JuperTronic/Jupertronic_Perculator_Mini_Pops/Perculator_Display_diagram.jpg

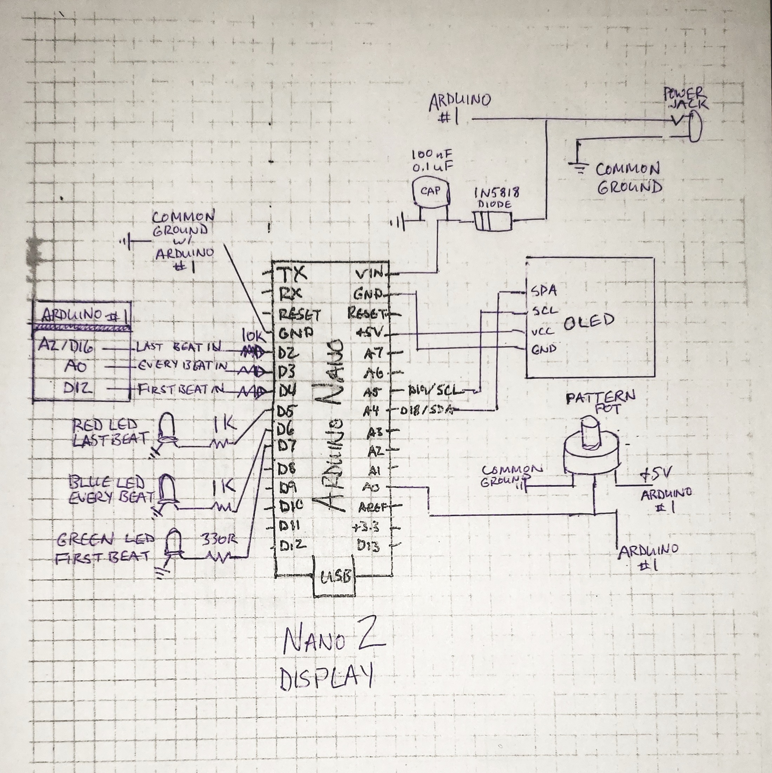
Perculator_Display_diagram.jpg
