JuperTronic/Jupertronic_Perculator_Mini_Pops/(threads)

Thread 1 (2022-04-20):

Pattern pot incorrectly wired

craigyjp, 2022-04-20:
I was interested in adding this display to my existing mini pops Wee 03 build, but looking at the pattern pot you seem to have the center pin wired to +5v so when rotated you would effectively short +5v to ground. I know the pin numbering is correct but the pdf file connections are not. Maybe I'm wrong, but the pattern value will never change as it stands currently.

JuperTronic, 2022-04-20:
Ahh yes, thank you for letting me know. As stated, I'm not a Fritzing wiz! I'll update that. Go by the hand drawing - center lug for signal of course.

JuperTronic, 2022-04-20:
Okay, just updated the Fritz schem pdf. Thanks again for bringing that to my attention!

craigyjp, 2022-04-20:
Thanks, just wanted to make sure before I added it to my build.

Thread 2 (2022-10-30):

Question regarding changes to the original TheWeeO3 code...

mayasfinest, 2022-10-30:
Hi, tremendous work you did and thank you for sharing it :-)

I built the "original" TheWeeO3 some months ago and love the things you could do when remote controlling it with a Korg SQ-1.
Have you touched any of the functionality regarding the CV and Korg LittleBits input in your code?
Do you think I could just build your machine with all of Mark Dammers CV-inputs?
[TheWeeO3-schematics.pdf](https://github.com/JuperTronic/Jupertronic_Perculator_Mini_Pops/files/9896188/TheWeeO3-schematics.pdf)

Greetings,
Jörg

JuperTronic, 2022-10-30:
Hi Jörg,

My psychic senses must have been tingling because I was just thinking about this a few days ago. I think there might be a slight change you'd want to make in my code. I'm not able to open the code right now, but I wanted to go ahead and respond. I'll try to look at the details soon. Here's what I remember. At the time I built the Perculator I didn't build in the CV jacks because I didn't have any equipment to drive it that way. I changed the way the LEDs work vs Mark Dammers' code, and I think I may have repurposed 1 or more pins of his CV output just for LED control. If you compare the code in that portion, you could probably just reset it to Mark's and the rest will work fine.

Actually now that I think about it, you should be able to add the second Arduino with OLED without touching the code or cicuit layout on your original WeeO3 Arduino at all. If you want to use my updated beat programs, just swap those in. The  second Arduino running the OLED just needs to get the input directly from the pattern potentiometer (which will also run to your WeeO3 Arduino - just attach 2 wires to the center pin of the potentiometer & and connect one to each Arduino - this is totally safe). Also create a common ground from each Arduino. The Arduinos themselves don't communicate to each other. So adding the OLED controlling Arduino does not require code changes to the beat making Arduino.

After all that rambling, I hope that makes sense. The WeeO3 original should work just fine.

I hope that helps! I'd love to hear how your project goes. Please let me know. I was thinking of going back to the WeeO3 CV design now that I have a Beatstep Pro as I think I can use it to send CV controls to expand the pattern possibilities on the Perculator.

Wishing you well,
Janis

-------- Original message --------
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

mayasfinest, 2022-10-30:
Hi Janis, thanks for the extensive answer, I very much appreciate it.
These CV-In's are really fun and open up the machine for a new experience, you should definately try it out.
The patterns are due to their preset nature quite limited and just turning on/off instruments is always "dejà-vueish".
You can do crazy things with CV-pitch and CV-sequencing up to the level of unrecognizable.
I'll try what you suggested, but the enclosure of my "Son of 8 Bit" (as I called my machine ;-) is overcrowded with pots and LEDs so I maybe build a new one... as I also miss a resonant filter and a volume knob before the output.

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

I am a rookie programmer and this code is far beyond my skills, so I'd love to see you doing the implementation of the CVs, if you don't mind :-) Maybe it's just a piece of cake for you...? I'll have to order these nice displays anyway (great idea btw)

In Germany it's evening, so have a nice one
and let me know, if you plan to actually change the code for "us" ...
Jörg
