JuperTronic/Jupertronic_Perculator_Mini_Pops/Perculator_Display_schem.pdf

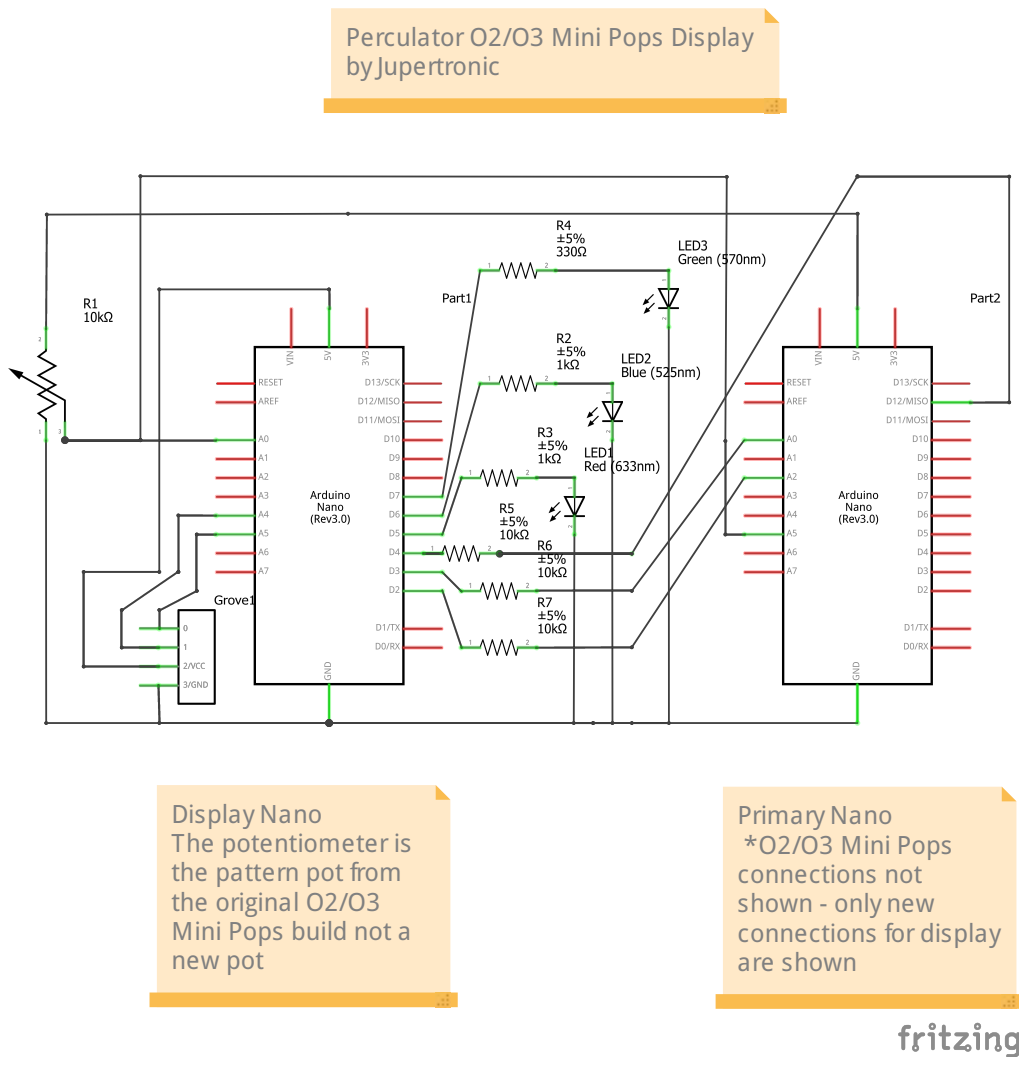
[picture p4: page 1]

Perculator O2/O3 Mini Pops Display
by Jupertronic

Display Nano
The potentiometeris
the pattern pot from
the original O2/O3
Mini Pops build not a
new pot

Primary Nano
*O2/O3 Mini Pops
connections not
shown - only new
connections for display
are shown
