JuperTronic/Jupertronic_Perculator_Mini_Pops/Jupertronic_Perculator_O3Minipops/Jupertronic_Perculator_O3Minipops.ino

// Perculator Mini Pops Drum Machine 2022
// Janis Wilson Hughes aka Jupertronic aka vitalWho aka J Dub aka Evolution Stoneware (youtube)
// Original code: O2 Minipops rhythm box (c) DSP Synthesizers 2016
// Free for non commercial use - http://janostman.wordpress.com - (website no longer working)
// See revival of this project by Bloghoskins.
// This iteration based on The Wee O3 by Mark Dammer 2020 - 'An ionized O2 Minipops' with awesome enhanced functionality. https://github.com/mark-orion/The-Wee-O3
// Thank you Jan, Bloghoskins, & Mark! 
// Changed LED flash to last beat of pattern
// Set up for 4 On the Floor beats and Rock Beats coded in Perculator_data.h
// Revised to use with a second Arduino board to run an OLED display showing the pattern name and number as well as operating LEDs.
// The pattern pot is wired with a second output going to the display Arduino's A0.
// A0, A2/D16, and D12 from this board go to display Arduino D3, D2, and D4 respectively with 10K resistors in series.


#include <avr/interrupt.h>
#include <avr/io.h>
#include <avr/pgmspace.h>
#include "Perculator_data.h"

#ifndef cbi
#define cbi(sfr, bit) (_SFR_BYTE(sfr) &= ~_BV(bit))
#endif
#ifndef sbi
#define sbi(sfr, bit) (_SFR_BYTE(sfr) |= _BV(bit))
#endif

// Standard Arduino Pins

#define digitalPinToPortReg(P) \
  (((P) >= 0 && (P) <= 7) ? &PORTD : (((P) >= 8 && (P) <= 13) ? &PORTB : &PORTC))
#define digitalPinToDDRReg(P) \
  (((P) >= 0 && (P) <= 7) ? &DDRD : (((P) >= 8 && (P) <= 13) ? &DDRB : &DDRC))
#define digitalPinToPINReg(P) \
  (((P) >= 0 && (P) <= 7) ? &PIND : (((P) >= 8 && (P) <= 13) ? &PINB : &PINC))
#define digitalPinToBit(P) \
  (((P) >= 0 && (P) <= 7) ? (P) : (((P) >= 8 && (P) <= 13) ? (P) - 8 : (P) - 14))


#define digitalReadFast(P) bitRead(*digitalPinToPINReg(P), digitalPinToBit(P))

#define digitalWriteFast(P, V) bitWrite(*digitalPinToPortReg(P), digitalPinToBit(P), (V))

const unsigned char PS_128 = (1 << ADPS2) | (1 << ADPS1) | (1 << ADPS0);




//--------- Ringbuf parameters ----------
uint8_t Ringbuffer[256];
uint8_t RingWrite = 0;
uint8_t RingRead = 0;
volatile uint8_t RingCount = 0;
volatile uint16_t SFREQ;
//-----------------------------------------


ISR(TIMER1_COMPA_vect) {

  //-------------------  Ringbuffer handler -------------------------

  if (RingCount) {                            //If entry in FIFO..
    OCR2A = Ringbuffer[(RingRead++)];          //Output LSB of 16-bit DAC
    RingCount--;
  }

  //-----------------------------------------------------------------

}



void setup() {

  OSCCAL = 0xFF;

  //Drum mute inputs
  pinMode(2, INPUT_PULLUP);
  pinMode(3, INPUT_PULLUP);
  pinMode(4, INPUT_PULLUP);
  pinMode(5, INPUT_PULLUP);
  pinMode(6, INPUT_PULLUP);
  pinMode(7, INPUT_PULLUP);
  pinMode(8, INPUT_PULLUP);
  pinMode(9, INPUT_PULLUP);

  pinMode(10, INPUT_PULLUP); //RUN - Stop input
  pinMode(12, OUTPUT);      //Reset output
  pinMode(13, OUTPUT);      //Clock output
  pinMode(16, OUTPUT);      //Last step indicator

  pinMode(14, OUTPUT);      //SEQ cnt output
  pinMode(15, OUTPUT);
//  pinMode(16, OUTPUT);
  pinMode(17, OUTPUT);


  //8-bit PWM DAC pin
  pinMode(11, OUTPUT);

  // Set up Timer 1 to send a sample every interrupt.
  cli();
  // Set CTC mode
  // Have to set OCR1A *after*, otherwise it gets reset to 0!
  TCCR1B = (TCCR1B & ~_BV(WGM13)) | _BV(WGM12);
  TCCR1A = TCCR1A & ~(_BV(WGM11) | _BV(WGM10));
  // No prescaler
  TCCR1B = (TCCR1B & ~(_BV(CS12) | _BV(CS11))) | _BV(CS10);
  // Set the compare register (OCR1A).
  // OCR1A is a 16-bit register, so we have to do this with
  // interrupts disabled to be safe.
  //OCR1A = F_CPU / SAMPLE_RATE;
  // Enable interrupt when TCNT1 == OCR1A
  TIMSK1 |= _BV(OCIE1A);
  sei();
  OCR1A = 800; //800 = 40KHz Samplefreq

  // Set up Timer 2 to do pulse width modulation on D11

  // Use internal clock (datasheet p.160)
  ASSR &= ~(_BV(EXCLK) | _BV(AS2));

  // Set fast PWM mode  (p.157)
  TCCR2A |= _BV(WGM21) | _BV(WGM20);
  TCCR2B &= ~_BV(WGM22);

  // Do non-inverting PWM on pin OC2A (p.155)
  // On the Arduino this is pin 11.
  TCCR2A = (TCCR2A | _BV(COM2A1)) & ~_BV(COM2A0);
  TCCR2A &= ~(_BV(COM2B1) | _BV(COM2B0));
  // No prescaler (p.158)
  TCCR2B = (TCCR2B & ~(_BV(CS12) | _BV(CS11))) | _BV(CS10);

  // Set initial pulse width to the first sample.
  OCR2A = 128;

  //set timer0 interrupt at 61Hz
  TCCR0A = 0;// set entire TCCR0A register to 0
  TCCR0B = 0;// same for TCCR0B
  TCNT0  = 0;//initialize counter value to 0
  // set compare match register for 62hz increments
  OCR0A = 255;// = 61Hz
  // turn on CTC mode
  TCCR0A |= (1 << WGM01);
  // Set CS01 and CS00 bits for prescaler 1024
  TCCR0B |= (1 << CS02) | (0 << CS01) | (1 << CS00);  //1024 prescaler

  TIMSK0 = 0;


  // set up the ADC
  SFREQ = analogRead(0);
  ADCSRA &= ~PS_128;  // remove bits set by Arduino library
  // Choose prescaler PS_128.
  ADCSRA |= PS_128;
  ADMUX = 64;
  sbi(ADCSRA, ADSC);
  PORTC = 0;
}




void loop() {

  uint16_t samplecntBD, samplecntBG2, samplecntCL, samplecntCW, samplecntCY, samplecntGU, samplecntMA, samplecntQU;

  samplecntBD = 0;
  samplecntBG2 = 0;
  samplecntCL = 0;
  samplecntCW = 0;
  samplecntCY = 0;
  samplecntGU = 0;
  samplecntMA = 0;
  samplecntQU = 0;

  uint16_t samplepntBD, samplepntBG2, samplepntCL, samplepntCW, samplepntCY, samplepntGU, samplepntMA, samplepntQU;

  int16_t total;

  uint8_t stepcnt = 0;
  uint16_t tempo = 3500;
  uint16_t tempocnt = 1;
  uint16_t tmptempo = 3500;
  uint16_t pitch = 800;
  uint8_t MUX = 4;

  uint8_t patselect = 0;
  uint8_t patlength = pgm_read_byte_near(patlen + patselect);
  uint8_t smpselect = 0;
  uint8_t smpstate = 0;
  bool smptrigger = false;
  bool extclock = false;
  byte clockstate = 0;
  byte clockstateold = 0;
  byte pinhigh = 1;
  byte pinlow = 0;

  while (1) {

    //------ Add current sample word to ringbuffer FIFO --------------------

    if (RingCount < 255) { //if space in ringbuffer
      total = 0;
      if (samplecntBD) {
        total += (pgm_read_byte_near(BD + samplepntBD++) - 128);
        samplecntBD--;
      }
      if (samplecntBG2) {
        total += (pgm_read_byte_near(BG2 + samplepntBG2++) - 128);
        samplecntBG2--;
      }
      if (samplecntCL) {
        total += (pgm_read_byte_near(CL + samplepntCL++) - 128);
        samplecntCL--;
      }
      if (samplecntCW) {
        total += (pgm_read_byte_near(CW + samplepntCW++) - 128);
        samplecntCW--;
      }
      if (samplecntCY) {
        total += (pgm_read_byte_near(CY + samplepntCY++) - 128);
        samplecntCY--;
      }
      if (samplecntGU) {
        total += (pgm_read_byte_near(GU + samplepntGU++) - 128);
        samplecntGU--;
      }
      if (samplecntMA) {
        total += (pgm_read_byte_near(MA + samplepntMA++) - 128);
        samplecntMA--;
      }
      if (samplecntQU) {
        total += (pgm_read_byte_near(QU + samplepntQU++) - 128);
        samplecntQU--;
      }
      if (total < -127) total = -127;
      if (total > 127) total = 127;
      cli();
      Ringbuffer[RingWrite] = total + 128;
      RingWrite++;
      RingCount++;
      sei();


      //----------------------------------------------------------------------------

      //--------- sequencer block ----------------------------------------------

      clockstate = digitalReadFast(13);
      if (!digitalReadFast(10) && ( !extclock || ( !clockstate && clockstateold ))) {
        if (!(tempocnt--)) {
          tempocnt = tempo;
          digitalWriteFast(13, pinhigh); //Clock out Hi
          uint8_t trig = pgm_read_byte_near(pattern + (patselect << 4) + stepcnt++);
          PORTC = stepcnt;
          uint8_t mask = (PIND >> 2) | ((PINB & 3) << 6);
          trig &= mask;
          if (stepcnt > patlength) stepcnt = 0;
          if (stepcnt == 0) digitalWriteFast(12, HIGH); //Reset out Hi
          if (stepcnt != 0) digitalWriteFast(12, LOW); //Reset out Lo
          if (stepcnt == patlength) digitalWriteFast(16, HIGH); //Send pulse on last step of pattern
          if (stepcnt != patlength) digitalWriteFast(16, LOW); //Not at end of pattern
          if (trig & 1) {
            samplepntQU = 0;
            samplecntQU = 7712;
          }
          if (trig & 2) {
            samplepntCY = 0;
            samplecntCY = 9434;
          }
          if (trig & 4) {
            samplepntMA = 0;
            samplecntMA = 568;
          }
          if (trig & 8) {
            samplepntCW = 0;
            samplecntCW = 830;
          }
          if (trig & 16) {
            samplepntCL = 0;
            samplecntCL = 752;
          }
          if (trig & 32) {
            samplepntBD = 0;
            samplecntBD = 1076;
          }
          if (trig & 64) {
            samplepntBG2 = 0;
            samplecntBG2 = 1136;
          }
          if (trig & 128) {
            samplepntGU = 0;
            samplecntGU = 2816;
          }
        }
        digitalWriteFast(13, pinlow); //Clock out Lo
      }
    }
    clockstateold = clockstate;
    if (digitalReadFast(10)) {
      digitalWriteFast(13, pinlow); //Clock out Lo
      digitalWriteFast(12, LOW); //Reset out Lo
      PORTC = patselect;
      stepcnt = 0;
      tempocnt = 1;
    }

    // -- manual trigger block

    if (smptrigger) {
      digitalWriteFast(13, pinhigh);
      switch (smpselect) {
        case 1:
          samplepntQU = 0;
          samplecntQU = 7712;
          break;

        case 2:
          samplepntCY = 0;
          samplecntCY = 9434;
          break;

        case 3:
          samplepntMA = 0;
          samplecntMA = 568;
          break;

        case 4:
          samplepntCW = 0;
          samplecntCW = 830;
          break;

        case 5:
          samplepntCL = 0;
          samplecntCL = 752;
          break;

        case 6:
          samplepntBD = 0;
          samplecntBD = 1076;
          break;

        case 7:
          samplepntBG2 = 0;
          samplecntBG2 = 1136;
          break;

        case 8:
          samplepntGU = 0;
          samplecntGU = 2816;
          break;

      }
      smptrigger = false;
    }

    //------------------------------------------------------------------------

    //--------------- ADC block -------------------------------------
    if (!(ADCSRA & 64)) {
      uint16_t value = ((ADCL + (ADCH << 8))) + 1;
      switch (MUX) {

        case 4:
          // select sample on rising edge, trigger on falling edge.
          if (smpstate >= 70 && value <= 69) smptrigger = true;
          if (smpstate >= 70 && value >= 70) smpselect = (value >> 7) + 1;
          smpstate = value;
          break;

        case 5:
          patselect = (value - 1) >> 6;
          patlength = pgm_read_byte_near(patlen + patselect);
          break;

        case 6:
          if (value > 980) {
            if (!extclock) {
              pinMode(13, INPUT_PULLUP);      //Clock input
              //pinMode(12, INPUT_PULLUP);      //Reset input
              pinlow = 1;
              extclock = true;
              tempo = 0;
              tempocnt = 0;
            }
          } else {
            if (extclock) {
              pinMode(13, OUTPUT);      //Clock output
              //pinMode(12, OUTPUT);      //Reset output
              pinlow = 0;
              extclock = false;
              digitalWriteFast(13, pinlow);
              //digitalWriteFast(12, pinlow);
            }
            tempo = (value << 3) + 400;;
          }
          break;

        case 7:
          OCR1A = (value << 2) + 256;
          break;
      }

      MUX++;
      if (MUX == 8) MUX = 4;
      ADMUX = 64 | MUX; //Select MUX
      sbi(ADCSRA, ADSC); //start next conversation
    };
    //---------------------------------------------------------------

  }
}
