JuperTronic/Jupertronic_Perculator_Mini_Pops/Jupertronic_Perculator_O3Minipops/Perculator_data.h

//Patterns GU BG2 BD CL CW MA CY QU
/*
16 steps, atered to 8th notes, 1 and 2 and 3 and 4 and
Patterns are described below
------------
4 on the Floor High hat every beat
4 on the Floor High hat every other beat
4 on the Floor Sizzle
Send Me an Angel
Sunglasses at Night
Pants Pants Turnaround
Obsession
Straight Up
Stand Back
I Can't Wait Fast
I Can't Wait Slow
Hard Rock
Rock
Reggae 
Synthpop
Samba

 */

const unsigned char patlen[16] PROGMEM = {15,15,15,15,15,15,15,15,15,15,15,15,15,15,15,15};

const unsigned char pattern[256] PROGMEM = {
// 1  Boots and Pants – Jogging Pants
B00100100,  
B00000100,
B00101110,
B00000100,
B00100100,
B00000100,
B00100111,
B00000100,
B00100100,
B00000100,
B00101110,
B00000100,
B00100100,
B00000100,
B00100111,
B00000100,

// 2 Boots and Pants Yoga Pants
B00100000,  
B00000100,
B00101010,
B00000100,
B00100000,
B00000100,
B00100011,
B00000100,
B00100000,
B00000100,
B00101010,
B00000100,
B00100000,
B00000100,
B00100011,
B00000100,

// 3 Boots and Pants Sizzle Pants
B00100000,  
B00000100,
B00101010,
B00000100,
B00100000,
B00000100,
B00100011,
B00000100,
B00100000,
B00000100,
B00101010,
B00000100,
B00100000,
B00000110, // Sizzle
B00100011,
B00000100,

// 4 Send Me An Angel Send Me Pants
B00100000,  
B00000100,
B00101010,
B00000100,
B00100000,
B00000100,
B00100011,
B00000100,
B00100000,
B00000100,
B00101010,
B00000100,
B00100000,
B00000110, // Sizzle
B00100011,
B00000110, // Sizzle

// 5 Boots and Pants Sunglasses At Night Pants at Night
B00100000,  
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
};
