JuperTronic/Jupertronic_Perculator_Mini_Pops/(commit log)

2022-04-12 Updated schematics
2022-04-12 Add files via upload
    Fritzing Schematic
2022-04-20 Updated error on schematic
